qwerty12399/OpenRobot-One/docs/assets/showcase/stm32f407zg-board.jpg

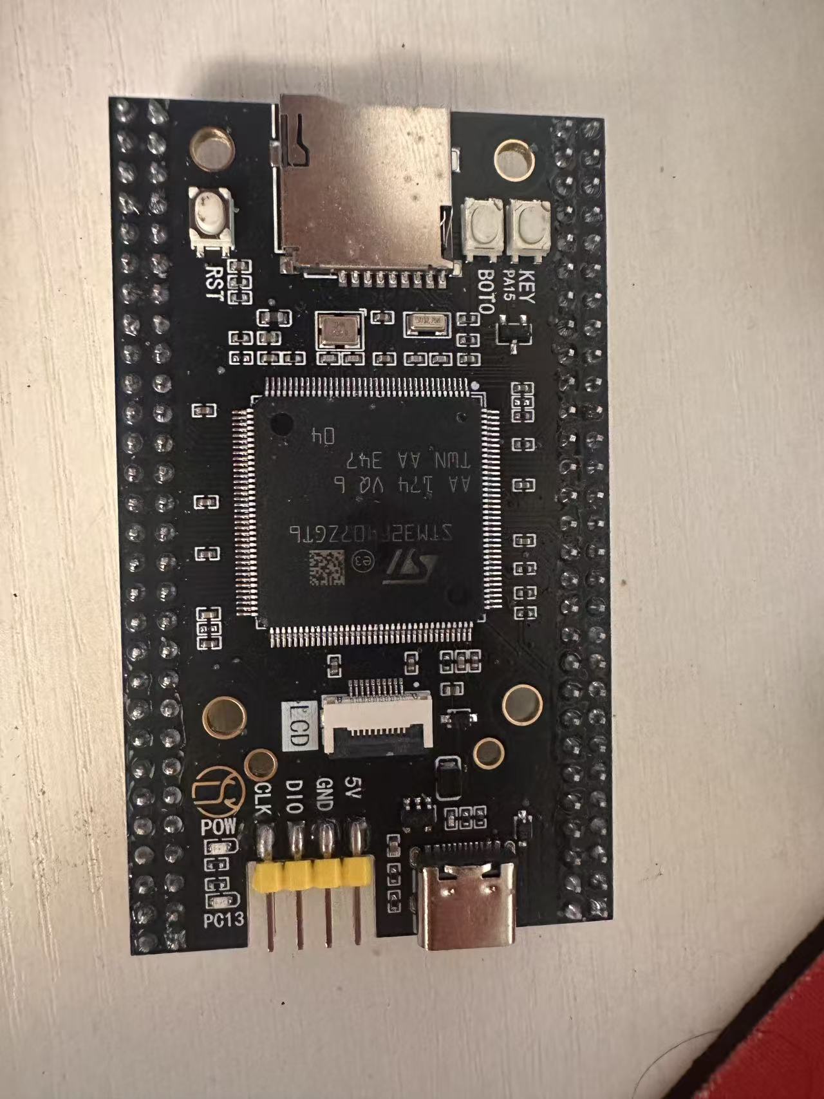
docs/assets/showcase/stm32f407zg-board.jpg
