qwerty12399/OpenRobot-One/docs/assets/showcase/ch340-usb-ttl.jpg

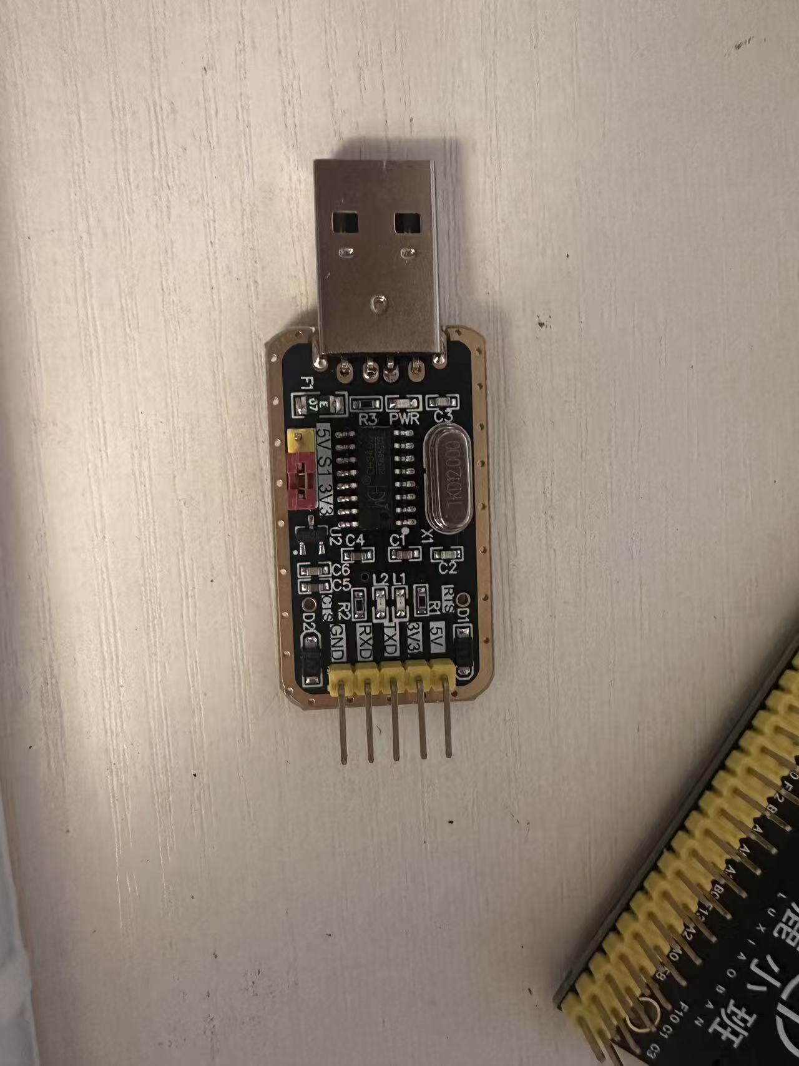
docs/assets/showcase/ch340-usb-ttl.jpg
