qwerty12399/OpenRobot-One/ros2_ws/src/openrobot_control/README.md

# openrobot_control

Planned boundary for velocity constraints and chassis-control coordination.
The wheel-speed PID remains on STM32; this package must not duplicate the
real-time controller. No runtime node is implemented yet.
