qwerty12399/OpenRobot-One/ros2_ws/src/openrobot_task/README.md

# openrobot_task

Planned boundary for the `IDLE`, `SEARCH`, `ALIGN`, `APPROACH`, `ARRIVED`, and
`FAULT` states. Every stale, invalid, or unhealthy input must converge to zero
velocity. No runtime node is implemented yet.
