qwerty12399/OpenRobot-One/ros2_ws/src/openrobot_vision/README.md

# openrobot_vision

Planned boundary for USB-camera acquisition, OpenCV preprocessing, red-object
detection, and later YOLO inference. Detection health and timestamps are part
of the contract. No runtime node or model dependency is implemented yet.
