qwerty12399/OpenRobot-One/docs/architecture.md

# OpenRobot-One 分层验证架构

## 总体架构

```mermaid
flowchart LR
    cmd[/cmd_vel/] --> kin[差速运动学]
    kin --> mode{执行模式}
    mode -->|仿真| gz[Gazebo 双轮底盘]
    mode -->|真机台架| drv[ROS 2 串口驱动]
    drv --> uart[UART + CRC + Watchdog]
    uart --> mcu[STM32 双通道 PID]
    mcu --> bts[2 x IBT-2/BTS7960]
    bts --> motors[2 x JGA25-370]
    motors --> enc[双 AB 编码器]
    enc --> mcu
    mcu --> drv
    drv --> bench[/bench/odom_estimate/]
    gz --> sim[/odom + joint_states + scan + TF/]
    sim --> slam[SLAM Toolbox]
```

仿真和真机不是两个无关项目：两者共享 `/cmd_vel`、差速公式、轮系参数版本、左右轮命令/反馈语义和参考向量。仿真验证系统级导航接口，真机验证真实执行与安全链路。

## 当前完成状态

| 层 | 状态 | 证据 |
| --- | --- | --- |
| ROS 2/Gazebo/SLAM | 实际通过 | 构建、Topic、TF、LaserScan和SLAM报告 |
| STM32 H2/UART | 实际通过 | 下载、verify、压力、异常恢复和重连 |
| BTS7960双电机 | 实际通过 | 四方向及双电机架空闭环日志 |
| 双编码器/PI | 实际通过 | ±100 RPM及差速方向反馈 |
| ROS 2真机台架 | 实际通过 | `/cmd_vel`、超时停车、JointState、架空估算与TF |

## TF所有权

仿真模式：

- SLAM Toolbox或AMCL二选一发布 `map -> odom`；
- Gazebo差速插件发布 `odom -> base_footprint`；
- `robot_state_publisher`发布机器人内部TF。

真机架空台架：

- 不发布 `map -> odom`；
- 不发布 `odom -> base_footprint`；
- 不发布替代的底盘TF；
- `/bench/odom_estimate`只表达架空编码器数学积分。

## 参数所有权

- 轮径、轮距、限速、方向和通信参数必须版本化。
- 仿真值与实测值分别标注来源。
- 编码器计数为0或UNKNOWN时禁止非零真机命令。
- Topic通过参数或remapping配置，不在源码硬编码。

## 固件责任

- 上电、复位、Fault和超时默认禁用两块驱动；
- 四个EN独立控制并具有外部下拉；
- 100Hz双速度环、计数/RPM计算和输出限幅；
- 500ms运动命令看门狗独立于传输心跳；
- UART状态、故障和序号可追踪。

## 当前范围外

落地底盘、真实里程计精度、真机SLAM/Nav2、视觉、任务AI、micro-ROS和`ros2_control`不属于当前完成标准。
