qwerty12399/OpenRobot-One/docs/evidence/2026-09-04-h3-motor-pulse.md

# H3 双电机逐通道短脉冲实测记录

日期：2026-09-04  
硬件：STM32F407ZGT6、IBT-2/BTS7960 ×2、GA25-370 12 V编码器电机 ×2  
串口：USART1，115200 8N1，CH340 COM4  
固件ELF SHA-256：`D9F62693B613EF3ABD30CC00D0BA8F5A33B0DA712EB0EFB29CB57B92C94CCA4F`

## 安全与无动力检查

- 3.3 V轨实测3.3 V，5 V轨实测5 V。
- 急停按下时BTS动力端为0 V，解除后为12 V。
- 启动后PC0-PC3实测为0 V。
- 无动力协议测试通过：`MOTOR-STOPPED`、`STATE=IDLE`、未授权脉冲返回`MOTOR-DENIED`。
- 停机后寄存器读取：`GPIOC ODR=0x00002000`，TIM3 CCR1-CCR4均为0。

## 编码器手转结果

- 左物理电机A的编码器连接PA0/PA1，对应TIM2；顺时针计数为负，逆时针计数为正。
- 右物理电机B的编码器连接PE9/PE11，对应TIM1；双向手转计数有效。
- 动力、BTS控制和编码器左右对应关系已逐线复核一致。

## 启动阈值探索

| PWM | 时间 | 通道 | 结果 |
| ---: | ---: | --- | --- |
| 5% | 100 ms | 左FWD | 两次均`DELTA=0`，未形成有效轴转动 |
| 10% | 100 ms | 左FWD | `DELTA=0`，现场听到震动声 |
| 20% | 100 ms | 左FWD | 输出轴出现可见转动 |

因此当前证据只能支持：左电机启动阈值大于10%且不高于20%。尚未测得精确最小启动占空比。

## 20%逐通道结果

所有命令均先执行一次未授权拒绝，再执行一次性ARM和单次脉冲，完成后状态均回到`IDLE`。

| 命令 | 选中编码器 | 起始 | 100 ms截止 | 截止增量 | 随后状态值 | 未选中编码器 |
| --- | --- | ---: | ---: | ---: | ---: | --- |
| LEFT FWD | TIM2 | 272 | 227 | -45 | 219 | TIM1保持412 |
| LEFT REV | TIM2 | 188 | 223 | +35 | 228 | TIM1保持412 |
| RIGHT FWD | TIM1 | 412 | 371 | -41 | 364 | TIM2保持248 |
| RIGHT REV | TIM1 | 343 | 386 | +43 | 395 | TIM2保持248 |

物理方向记录：

- `LEFT FWD`：从输出轴端观察为逆时针，TIM2为负。
- `LEFT REV`：从输出轴端观察为顺时针，TIM2为正。
- `RIGHT FWD`：从输出轴端观察为顺时针，TIM1为负。
- `RIGHT REV`：TIM1为正，现场报告无异常；输出轴物理方向没有单独口述记录，保持`UNKNOWN`。

## 结论与未完成项

已实测通过：

- 两个电机均能在20% PWM、100 ms命令下形成有效编码器计数。
- 四种电气方向均只驱动选中通道，未选中编码器保持稳定。
- 一次性授权、未授权拒绝、TIM6自动停车和最终`IDLE`状态通过。
- 停机后PWM与EN寄存器为0。

仍未完成：

- 使用示波器或逻辑分析仪测量真实脉冲持续时间；当前100 ms来自TIM6配置和软件状态，不属于外部仪器实测。
- 脉冲期间STOP、复位、断开串口和退出上位机的故障注入测试。
- 左右电机精确启动阈值、每输出轴转计数和持续开环范围。
- RPM估算、单路PID、双路PID和500 ms持续运动看门狗。
- 电流峰值、温升和电源压降原始记录。

因此本记录支持“H3逐通道运动基本功能通过”，不支持“H3全部故障安全测试完成”或“双电机闭环完成”。
