qwerty12399/OpenRobot-One/docs/assets/demo/README.md

# 真机架空台架演示

- [65秒完整演示](hardware-demo-full.mp4)：主展示视频；
- [20秒短演示](hardware-demo-short.mp4)：补充展示视频。

视频展示的是无轮、架空双电机测试台，不代表机器人已经落地运行。验收结论以
[7/7硬件回归记录](../../evidence/2026-09-05-hardware-acceptance.md)为准。
