qwerty12399/OpenRobot-One/docs/evidence/2026-09-05-pc-control-watchdog.md

# PC 连续控制与通信超时停车

## 用户实测确认

2026-09-05，用户在当前任务确认：连续控制和 `WATCHDOG PASS` 均已通过。

该结论来源于用户报告。本次没有重新驱动电机，未取得对应原始终端日志、
运行脚本版本、已烧录 ELF 哈希或仪器波形。因此不记录精确停车时延、
不把串口观察结果写成硬件计时测量，也不宣称独立硬件看门狗已验收。

当前脚本的看门狗模式先发送五秒 `V,100,100`，随后停止发送，继续接收。
它要求先看到有效运动目标和输出，再观察到目标和输出归零，以及连续三帧
全零反馈。主动停车清理在观察结束或失败之后执行。

## 本轮本地验证

- 修复串口读取超时时丢弃半帧的问题；超过 96 字节的行丢弃到换行再恢复。
- 九项离线测试通过，覆盖连续控制、异常停车、看门狗缺失、旧零反馈、
  分段接收和超长帧恢复；Ruff 检查通过。
- Windows 枚举到 `USB-SERIAL CH340 (COM4)`，仅枚举，没有打开串口。
- WSL `Ubuntu-22.04` 已有 `/opt/ros/humble/setup.bash` 和 `colcon`。
- WSL 未枚举到 `/dev/ttyUSB*` 或 `/dev/ttyACM*`；Windows PATH 未找到 usbipd。
- Docker 服务可访问，服务端版本 29.5.3；本地有 `openrobot-one:humble` 镜像。

## 后续进展

本记录形成后，`openrobot_driver` 已完成串口接入、差速换算、ASCII帧收发、
300 ms主机命令超时、`/joint_states` 与 `/bench/odom_estimate` 发布，并通过
7/7真机回归。最新结果见
[2026-09-05-hardware-acceptance.md](2026-09-05-hardware-acceptance.md)。

最终仓库边界以项目约束为准：台架只发布 `/bench/odom_estimate` 数据，不广播
底盘TF。

## ROS 2架空估算阶段性复验

2026-09-05，本轮通过WSL直通的CH340 `/dev/ttyUSB0` 启动ROS 2驱动：

- 零速时 `/bench/odom_estimate` 的线速度和角速度均为0；
- 以 `linear.x=0.17 m/s` 连续发送命令约3秒，运动中捕获线速度
  `0.078278 m/s`、角速度 `0.125278 rad/s`；
- 架空积分位置捕获到 `x=0.140259 m`、`y=0.003864 m`；
- 命令停止后出现 `/cmd_vel timeout; commanding STOP`，随后线速度和角速度归0；
- 阶段调试时曾验证隔离TF能随估算发布；最终版本按台架边界关闭并移除TF
  广播，只保留 `/bench/odom_estimate` 数据。

这些数值是无轮架空台架的编码器数学积分，不代表地面实际距离或转角。
直行命令中出现非零角速度，反映左右电机瞬时速度差和名义轮距换算，不能
据此声称里程计精度；底盘落地后仍需轮径、轮距和打滑标定。

现有 `robot.yaml` 中轮径和轮距是仿真参考值，不是实测底盘尺寸。
后续换算和估算必须明确此边界；当前固件不提供累计编码器计数，不能伪造
`left_encoder_count` / `right_encoder_count` 实测消息。
