qwerty12399/OpenRobot-One/docs/assets/showcase/bts7960-ibt2-seller-reference.jpg

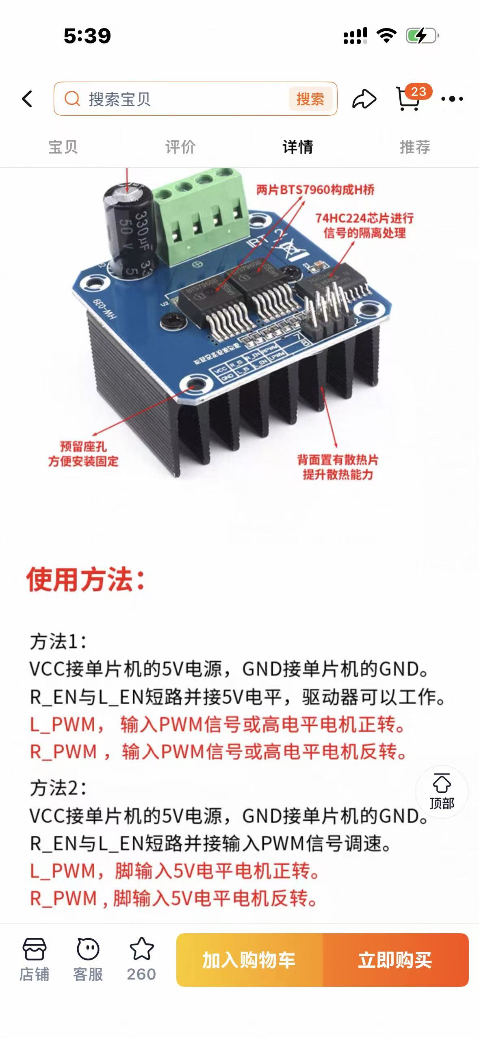
docs/assets/showcase/bts7960-ibt2-seller-reference.jpg
