qwerty12399/OpenRobot-One/docs/hardware_bom.md

# 双电机架空闭环硬件清单

当前真机目标是无轮、架空的双电机速度闭环，不要求底盘、轮子、电池或车载计算机。

## 已购核心硬件

| 类别 | 当前规格 | 数量 | 状态 |
| --- | --- | ---: | --- |
| 主控 | STM32F407ZGT6 开发板 | 1 | H2 已验证 |
| 下载调试 | ST-Link V2 | 1 | 已使用 |
| 串口 | CH340 USB-TTL | 1 | USART1 H2 已验证 |
| 驱动 | IBT-2/BTS7960 模块 | 2 | 商品资料已保存，实物电气未验收 |
| 电机 | JGA25-370，12 V/620 RPM，带 AB 编码器 | 2 | 已购，关键参数待实测 |
| 动力电源 | 12 V/5 A 适配器 | 1 | 已购，固定输出、无可调限流证据 |
| 分线 | 一进二出端子 | 正负各1 | 已购 |
| 动力线 | 20 AWG | 若干 | 已购 |
| 控制线 | 2.54 mm 杜邦线 | 若干 | 只用于信号 |

已购数量来自用户最新说明；到货型号、数量和端子仍需实物照片核对。

## 通电前仍必须具备

| 物品/条件 | 最低要求 | 目的 |
| --- | --- | --- |
| 数字万用表 | 电压、电阻、通断 | 极性、短路、逻辑和编码器电平 |
| 保险丝与座 | 每分支初始规格经实测冻结 | 防止线路和小电机承受模块几十安培级保护阈值 |
| 直流总开关/急停 | 明确 DC 额定 | 人工立即断电 |
| 限流 | 优先可调限流电源 | 首次脉冲限制故障能量 |
| EN 下拉 | PC0-PC3 各约 10 kΩ 到 GND | MCU 复位时禁用两块驱动 |
| 固定与绝缘 | 两电机、两驱动可靠固定 | 防旋转、短路和松线 |

仅有 12 V/5 A 适配器、一进二出端子和 BTS7960 内部保护，不能通过 H0/H1。

## 必须实测后冻结

- 两块模块的 VCC、3.3 V输入兼容性、端子方向和温升；
- 两台电机空载、启动和受控堵转电流；
- 两路编码器供电、输出类型、A/B电平、方向和每输出轴一圈计数；
- 保险丝规格、线材温升和电源压降；
- 左右电机符号、可控转速范围和安全最高目标；
- 轮径、轮距只作为版本化仿真/估算参数，未装轮时不得称为实测几何。

## 远期扩展

底盘、轮子、万向轮、电池、降压模块和落地里程计不属于当前闭环前置，只有完成架空 H0–H5 后再评估。
