qwerty12399/OpenRobot-One/firmware/openrobot_firmware/Core/Src/main.c

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

/* Includes ------------------------------------------------------------------*/
#include "main.h"

/* USER CODE BEGIN Includes */
#include "motor_control.h"
#include "protocol.h"
/* USER CODE END Includes */

TIM_HandleTypeDef htim1;
TIM_HandleTypeDef htim2;
TIM_HandleTypeDef htim3;
TIM_HandleTypeDef htim6;

UART_HandleTypeDef huart1;

/* USER CODE BEGIN PV */

/*
 * TIM6 = 100 Hz.
 * ISR only sets this flag.
 * The real control calculation runs in main().
 */
volatile uint8_t g_control_10ms_flag = 0U;

/* USER CODE END PV */

void SystemClock_Config(void);
static void MX_GPIO_Init(void);
static void MX_USART1_UART_Init(void);
static void MX_TIM1_Init(void);
static void MX_TIM2_Init(void);
static void MX_TIM3_Init(void);
static void MX_TIM6_Init(void);

/* USER CODE BEGIN PFP */

static void HardwareMotorSafeOff(void);

/* USER CODE END PFP */

/* USER CODE BEGIN 0 */

/**
 * @brief Immediately place both BTS7960 drivers into safe OFF state.
 *
 * This function does not depend on the PI controller state.
 * It is used for startup/error safety.
 */
static void HardwareMotorSafeOff(void)
{
    const uint32_t enable_pins =
        LEFT_R_EN_Pin  |
        LEFT_L_EN_Pin  |
        RIGHT_R_EN_Pin |
        RIGHT_L_EN_Pin;

    /*
     * If TIM3 clock is already enabled,
     * force all four PWM channels to zero.
     */
    if ((RCC->APB1ENR & RCC_APB1ENR_TIM3EN) != 0U)
    {
        TIM3->CCR1 = 0U;
        TIM3->CCR2 = 0U;
        TIM3->CCR3 = 0U;
        TIM3->CCR4 = 0U;
    }

    /*
     * Disable both BTS7960 boards.
     */
    if ((RCC->AHB1ENR & RCC_AHB1ENR_GPIOCEN) != 0U)
    {
        GPIOC->BSRR =
            ((uint32_t)enable_pins << 16U);
    }
}

void Motor_EmergencyStop(void)
{
    HardwareMotorSafeOff();
}

/* USER CODE END 0 */

/**
  * @brief  The application entry point.
  * @retval int
  */
int main(void)
{
    /* MCU Configuration--------------------------------------------------------*/

    HAL_Init();

    SystemClock_Config();

    /* Initialize all configured peripherals */
    MX_GPIO_Init();
    MX_USART1_UART_Init();
    MX_TIM1_Init();
    MX_TIM2_Init();
    MX_TIM3_Init();
    MX_TIM6_Init();

    /* USER CODE BEGIN 2 */

    /*
     * Always enter safe state before enabling
     * PWM/encoder/control peripherals.
     */
    HardwareMotorSafeOff();

    /*
     * MotorControl_Init() starts:
     *
     * TIM2 -> LEFT encoder
     * TIM1 -> RIGHT encoder
     * TIM3 -> PWM CH1~CH4
     */
    MotorControl_Init();

    /*
     * Start USART1 interrupt reception.
     */
    Protocol_Init(&huart1);

    /*
     * Start existing TIM6 100 Hz control scheduler.
     *
     * Do this exactly ONCE.
     */
    if (HAL_TIM_Base_Start_IT(&htim6) != HAL_OK)
    {
        Error_Handler();
    }

    /* USER CODE END 2 */

    /* Infinite loop */
    /* USER CODE BEGIN WHILE */

    while (1)
    {
        /*
         * Parse complete UART commands.
         */
        Protocol_Poll();

        /*
         * Formal mode:
         * 500 ms without a valid speed command -> STOP.
         */
        Protocol_CheckWatchdog();

        /*
         * Run control loop once for each TIM6 10 ms tick.
         */
        if (g_control_10ms_flag != 0U)
        {
            g_control_10ms_flag = 0U;

            MotorControl_Update10ms();
        }

        /*
         * Send telemetry every 100 ms.
         */
        Protocol_SendTelemetry();
    }

    /* USER CODE END WHILE */

}

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
/* USER CODE BEGIN 4 */

/**
 * @brief TIM6 100 Hz callback.
 *
 * ISR intentionally does NOT run the PI controller.
 * It only sets a scheduler flag.
 */
void HAL_TIM_PeriodElapsedCallback(
    TIM_HandleTypeDef *htim)
{
    if (htim->Instance == TIM6)
    {
        g_control_10ms_flag = 1U;
    }
}


/**
 * @brief USART interrupt receive-complete callback.
 *
 * This is the missing Step 20 callback.
 */
void HAL_UART_RxCpltCallback(
    UART_HandleTypeDef *huart)
{
    Protocol_RxCallback(huart);
}


void HAL_UART_ErrorCallback(
    UART_HandleTypeDef *huart)
{
    Protocol_ErrorCallback(huart);
}

/* USER CODE END 4 */
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
