qwerty12399/OpenRobot-One/firmware/openrobot_firmware/OpenRobotFirmware.ioc

Mcu.UserName=STM32F407ZGTx
PA0-WKUP.Signal=S_TIM2_CH1_ETR
PA1.Signal=S_TIM2_CH2
PA10.Signal=USART1_RX
PA13.Signal=SYS_JTMS-SWDIO
PA14.Signal=SYS_JTCK-SWCLK
PA9.Signal=USART1_TX
PB0.Signal=S_TIM3_CH3
PB1.Signal=S_TIM3_CH4
PC0.GPIO_Label=LEFT_R_EN
PC0.Signal=GPIO_Output
PC1.GPIO_Label=LEFT_L_EN
PC1.Signal=GPIO_Output
PC13-ANTI_TAMP.GPIO_Label=STATUS_LED
PC13-ANTI_TAMP.Signal=GPIO_Output
PC2.GPIO_Label=RIGHT_R_EN
PC2.Signal=GPIO_Output
PC3.GPIO_Label=RIGHT_L_EN
PC3.Signal=GPIO_Output
PC6.Signal=S_TIM3_CH1
PC7.Signal=S_TIM3_CH2
PE11.Signal=S_TIM1_CH2
PE9.Signal=S_TIM1_CH1
PH0-OSC_IN.Signal=RCC_OSC_IN
PH1-OSC_OUT.Signal=RCC_OSC_OUT
