qwerty12399/OpenRobot-One/firmware/openrobot_firmware/Core/Inc/main.h

#define STATUS_LED_Pin GPIO_PIN_13
#define STATUS_LED_GPIO_Port GPIOC
#define LEFT_R_EN_Pin GPIO_PIN_0
#define LEFT_R_EN_GPIO_Port GPIOC
#define LEFT_L_EN_Pin GPIO_PIN_1
#define LEFT_L_EN_GPIO_Port GPIOC
#define RIGHT_R_EN_Pin GPIO_PIN_2
#define RIGHT_R_EN_GPIO_Port GPIOC
#define RIGHT_L_EN_Pin GPIO_PIN_3
#define RIGHT_L_EN_GPIO_Port GPIOC
