qwerty12399/OpenRobot-One/(commit log)

2026-07-29 feat: complete first-week simulation and SLAM
    [base.xacro, common_properties.xacro, gazebo.xacro, inertial_macros.xacro, openrobot.urdf.xacro, sensor.xacro, wheel.xacro]
2026-09-01 feat: unify simulation bringup and package skeletons
    [robot.yaml]
2026-09-01 feat: add STM32 hardware bringup and validation
2026-09-01 docs: design BTS7960 single-motor transition
2026-09-01 docs: unify simulation and single-motor HIL
2026-09-01 docs: pivot to BTS7960 dual-motor bench
    [robot.yaml]
2026-09-04 docs: design safe motor pulse diagnostic
2026-09-05 verify STM32 dual motor closed loop and UART watchdog
    [openrobot_firmware (1).cfg]
2026-09-05 complete hardware MVP and curate public repository
    [robot.yaml]
